open-ephys/ephys-test-module-molc-64-chan/README.md

# Test Module for FOLC-based Headstages and Adapters

This test module works with the Open Ephys
[automated ephys tester](https://github.com/open-ephys/ephys-test-board). 
It can be used to verify the functionality of headstage-adapters and headstages that use the nanoZ/FOLC-110-01-S-Q_1 pinout.
