open-ephys/ephys-test-module-molc-64-chan/resources/nano-z_molc_pinout.ods

E0 | REF | REF | E24
E1 | x | x | E25
E2 | x | x | E26
E3 | x | x | E27
E5 | E4 | E29 | E28
E7 | E6 | E31 | E30
E9 | E8 | E17 | E16
E11 | E10 | E19 | E18
E13 | E12 | E21 | E20
E15 | E14 | E23 | E22
E32 | REF | REF | E56
E33 | x | x | E57
E34 | x | x | E58
E35 | x | x | E59
E37 | E36 | E61 | E60
E39 | E38 | E63 | E62
E41 | E40 | E49 | E48
E43 | E42 | E51 | E50
E45 | E44 | E53 | E52
E47 | E46 | E55 | E54
