open-ephys/ephys-test-module-molc-64-chan/pcb/ephys-test-module-molc-64-chan.pdf

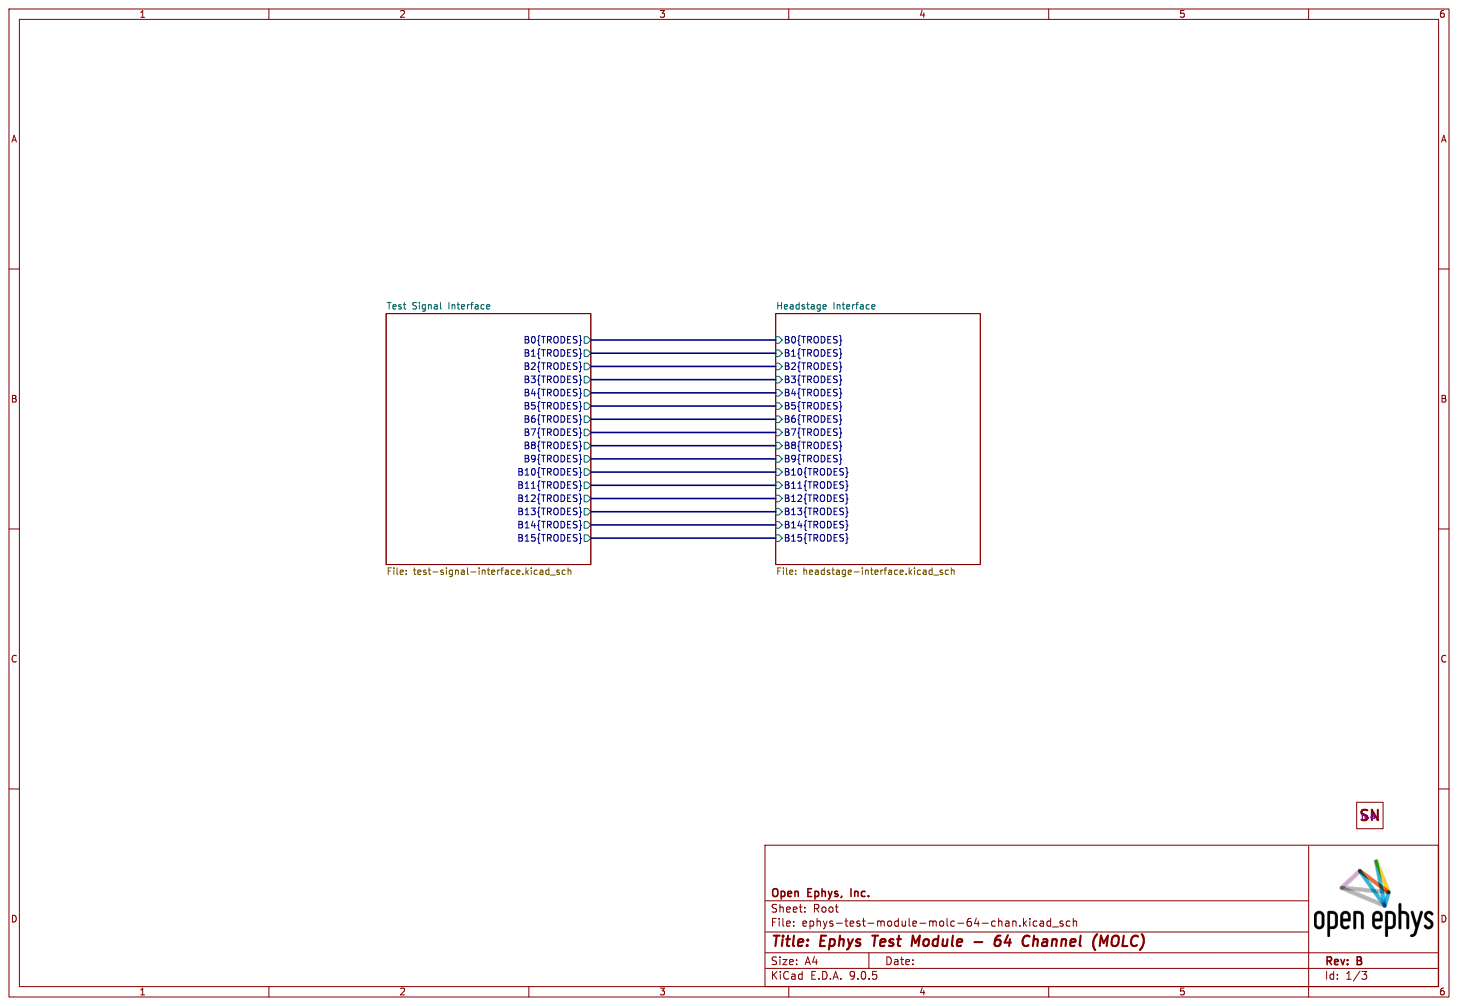
[picture p1: page 1]

B15{TRODES} Test Signal Interface File: test-signal-interface.kicad_sch

Headstage Interface File: headstage-interface.kicad_sch

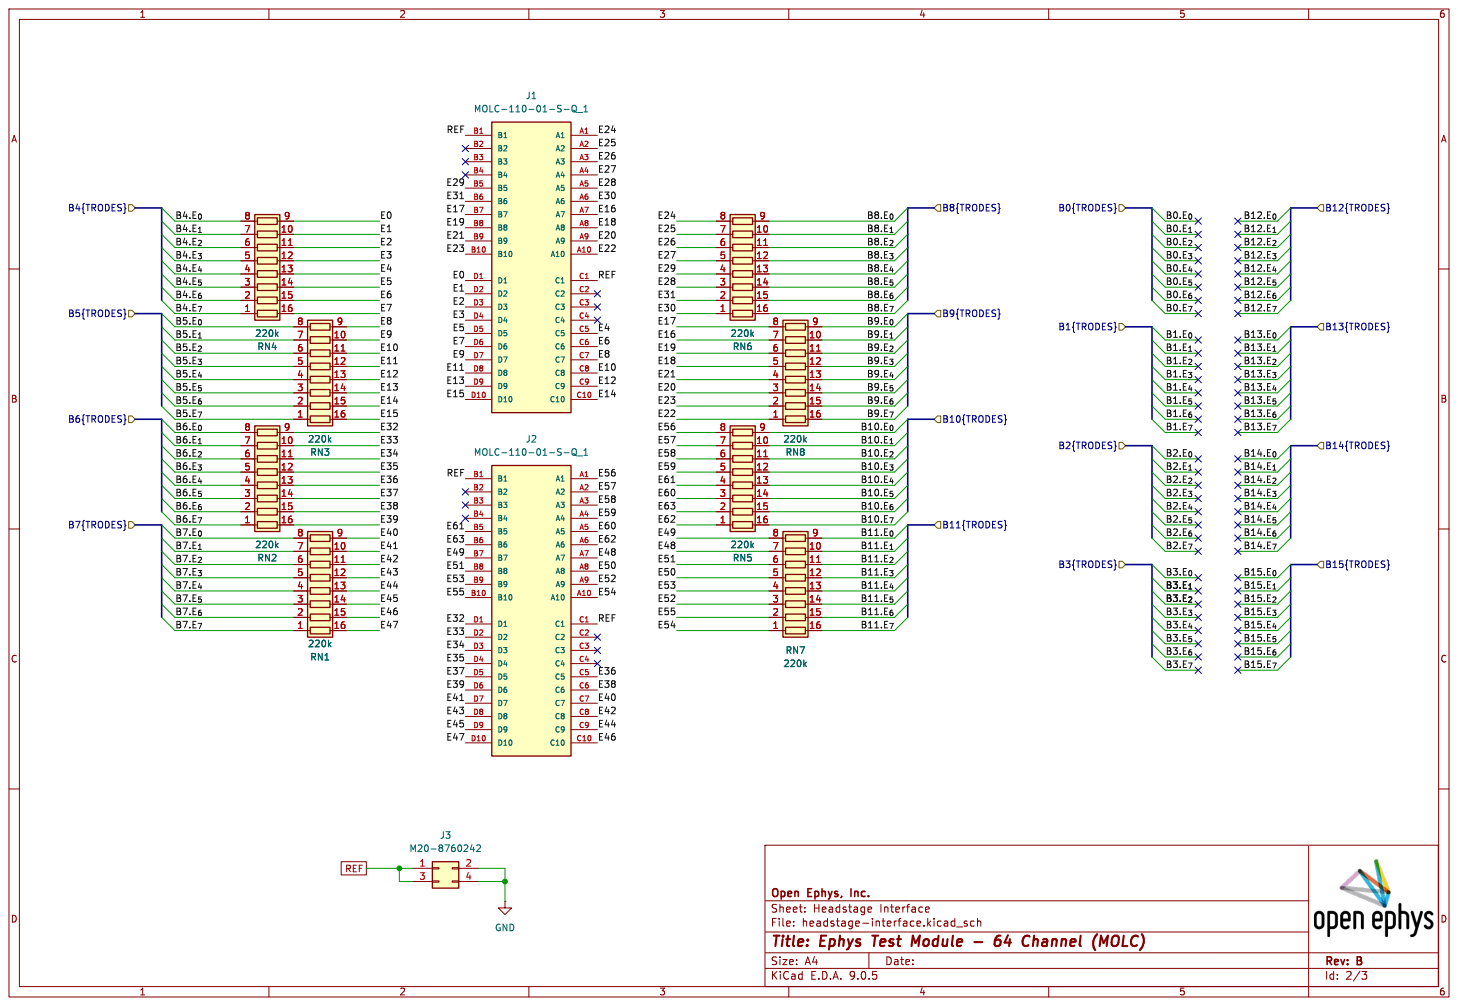
[picture p2: page 2]

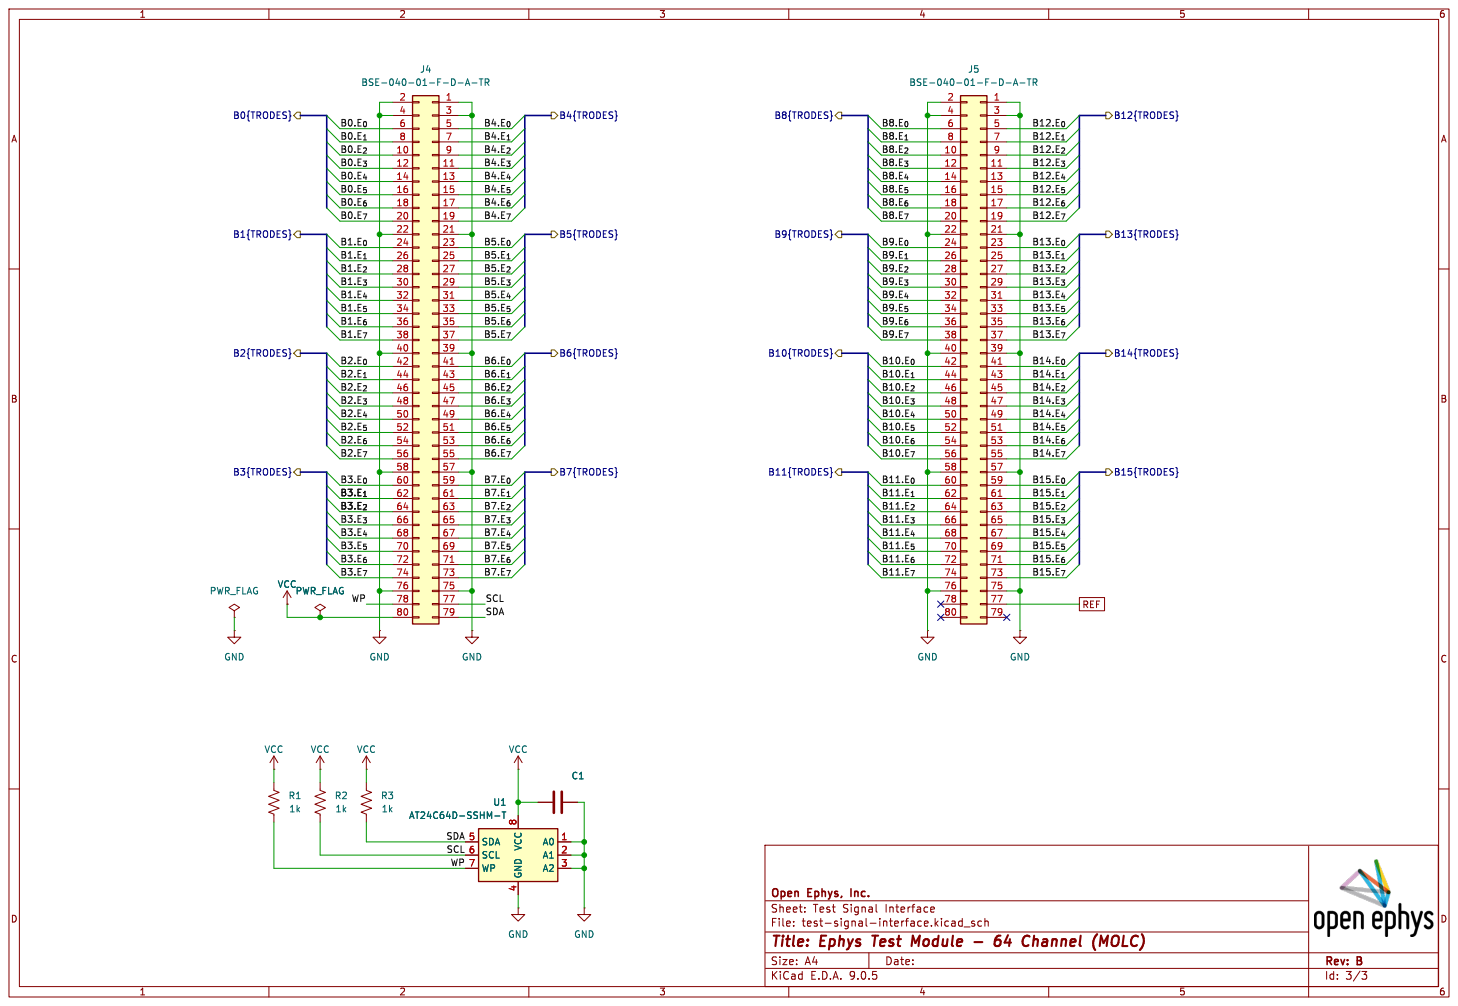
[picture p3: page 3]
