open-ephys/ephys-test-module-molc-64-chan/pcb/ephys-test-module-molc-64-chan.kicad_pcb

## KiCad design pcb/ephys-test-module-molc-64-chan.kicad_pcb (2025-11-03)

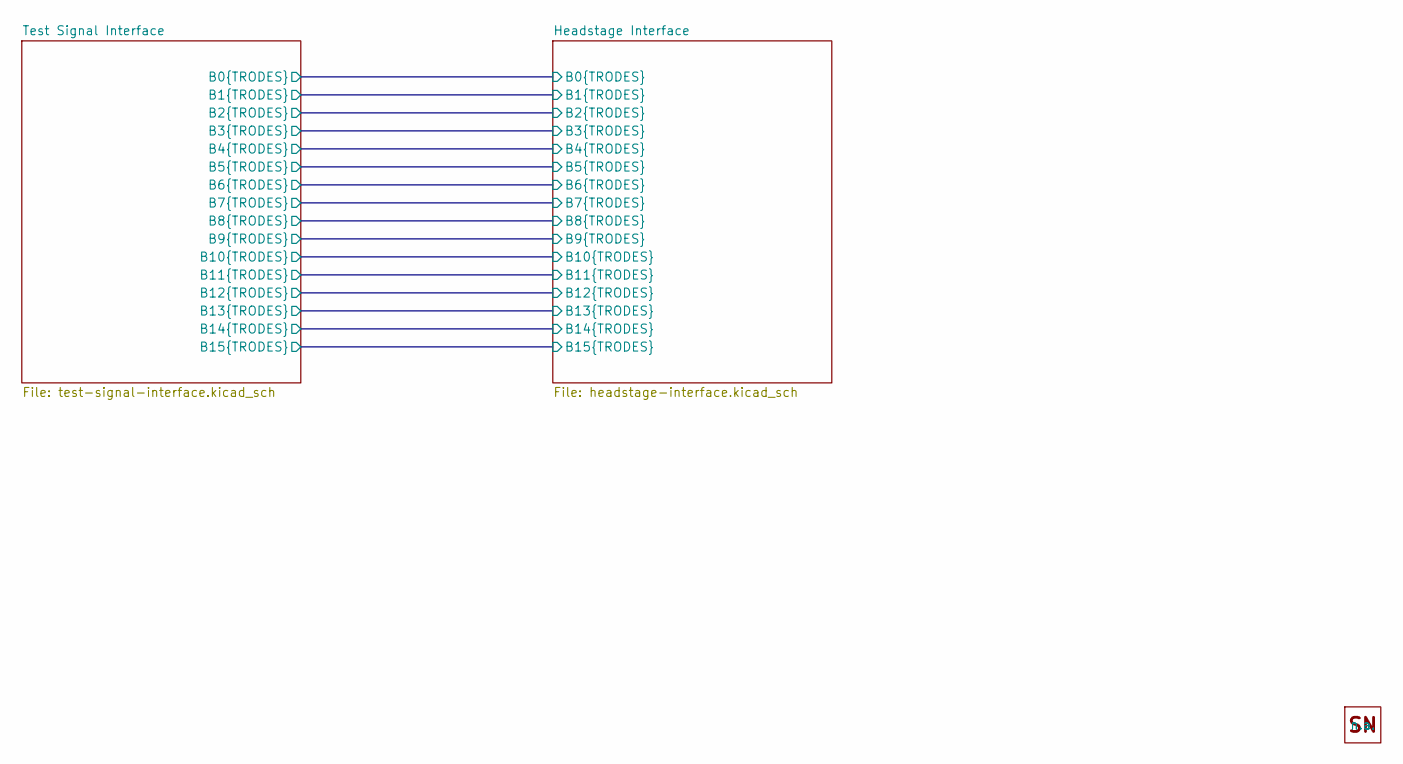
[picture p4: schematic ephys-test-module-molc-64-chan.kicad_sch, Ephys Test Module - 64 Channel (MOLC)]

Parts:
H1: OEPS_SN-STICKER-8x20mm; MPN n.a.

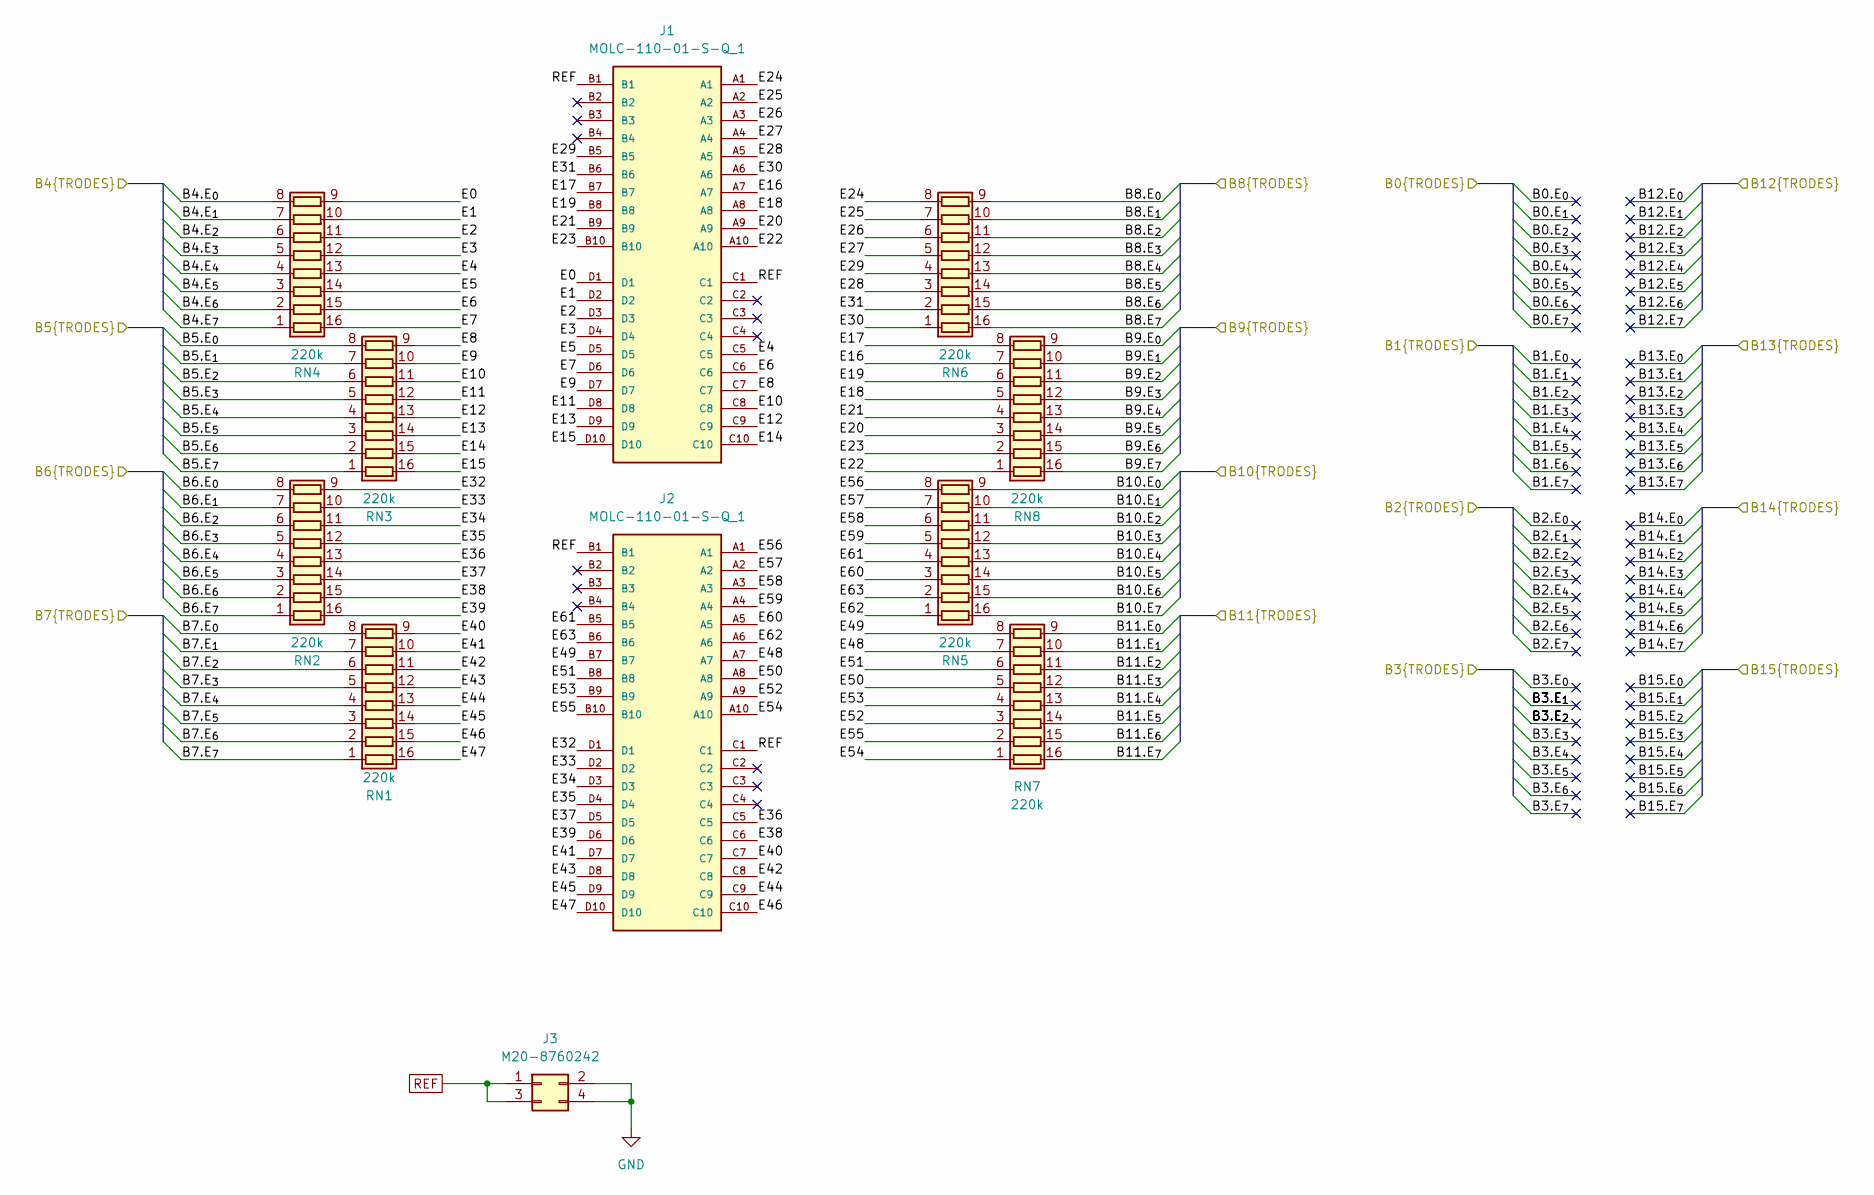
[picture p5: schematic headstage-interface.kicad_sch, Ephys Test Module - 64 Channel (MOLC)]

Parts:
J1, J2: MOLC-110-01-S-Q_1; SAMTEC_MOLC-110-01-S-Q; MPN MOLC-110-01-S-Q_1
J3: M20-8760242; PinHeader_2x02_P2.54mm_Vertical_SMD; MPN M20-8760242
RN1, RN2, RN3, RN4, RN5, RN6, RN7, RN8: 220k; R_Array_Convex_8x0602; Tolerance 5%; MPN YC248-JR-07220KL

Connections:
/Headstage Interface/B4.E_{0}: RN4.8 (R8.1); also elsewhere on the board
/Headstage Interface/B4.E_{1}: RN4.7 (R7.1); also elsewhere on the board
/Headstage Interface/B4.E_{2}: RN4.6 (R6.1); also elsewhere on the board
/Headstage Interface/B4.E_{3}: RN4.5 (R5.1); also elsewhere on the board
/Headstage Interface/B4.E_{4}: RN4.4 (R4.1); also elsewhere on the board
/Headstage Interface/B4.E_{5}: RN4.3 (R3.1); also elsewhere on the board
/Headstage Interface/B4.E_{6}: RN4.2 (R2.1); also elsewhere on the board
/Headstage Interface/B4.E_{7}: RN4.1 (R1.1); also elsewhere on the board
/Headstage Interface/B5.E_{0}: RN3.8 (R8.1); also elsewhere on the board
/Headstage Interface/B5.E_{1}: RN3.7 (R7.1); also elsewhere on the board
/Headstage Interface/B5.E_{2}: RN3.6 (R6.1); also elsewhere on the board
/Headstage Interface/B5.E_{3}: RN3.5 (R5.1); also elsewhere on the board
/Headstage Interface/B5.E_{4}: RN3.4 (R4.1); also elsewhere on the board
/Headstage Interface/B5.E_{5}: RN3.3 (R3.1); also elsewhere on the board
/Headstage Interface/B5.E_{6}: RN3.2 (R2.1); also elsewhere on the board
/Headstage Interface/B5.E_{7}: RN3.1 (R1.1); also elsewhere on the board
/Headstage Interface/B6.E_{0}: RN2.8 (R8.1); also elsewhere on the board
/Headstage Interface/B6.E_{1}: RN2.7 (R7.1); also elsewhere on the board
/Headstage Interface/B6.E_{2}: RN2.6 (R6.1); also elsewhere on the board
/Headstage Interface/B6.E_{3}: RN2.5 (R5.1); also elsewhere on the board
/Headstage Interface/B6.E_{4}: RN2.4 (R4.1); also elsewhere on the board
/Headstage Interface/B6.E_{5}: RN2.3 (R3.1); also elsewhere on the board
/Headstage Interface/B6.E_{6}: RN2.2 (R2.1); also elsewhere on the board
/Headstage Interface/B6.E_{7}: RN2.1 (R1.1); also elsewhere on the board
/Headstage Interface/B7.E_{0}: RN1.8 (R8.1); also elsewhere on the board
/Headstage Interface/B7.E_{1}: RN1.7 (R7.1); also elsewhere on the board
/Headstage Interface/B7.E_{2}: RN1.6 (R6.1); also elsewhere on the board
/Headstage Interface/B7.E_{3}: RN1.5 (R5.1); also elsewhere on the board
/Headstage Interface/B7.E_{4}: RN1.4 (R4.1); also elsewhere on the board
/Headstage Interface/B7.E_{5}: RN1.3 (R3.1); also elsewhere on the board
/Headstage Interface/B7.E_{6}: RN1.2 (R2.1); also elsewhere on the board
/Headstage Interface/B7.E_{7}: RN1.1 (R1.1); also elsewhere on the board
/Headstage Interface/B8.E_{0}: RN6.9 (R8.2); also elsewhere on the board
/Headstage Interface/B8.E_{1}: RN6.10 (R7.2); also elsewhere on the board
/Headstage Interface/B8.E_{2}: RN6.11 (R6.2); also elsewhere on the board
/Headstage Interface/B8.E_{3}: RN6.12 (R5.2); also elsewhere on the board
/Headstage Interface/B8.E_{4}: RN6.13 (R4.2); also elsewhere on the board
/Headstage Interface/B8.E_{5}: RN6.14 (R3.2); also elsewhere on the board
/Headstage Interface/B8.E_{6}: RN6.15 (R2.2); also elsewhere on the board
/Headstage Interface/B8.E_{7}: RN6.16 (R1.2); also elsewhere on the board
/Headstage Interface/B9.E_{0}: RN8.9 (R8.2); also elsewhere on the board
/Headstage Interface/B9.E_{1}: RN8.10 (R7.2); also elsewhere on the board
/Headstage Interface/B9.E_{2}: RN8.11 (R6.2); also elsewhere on the board
/Headstage Interface/B9.E_{3}: RN8.12 (R5.2); also elsewhere on the board
/Headstage Interface/B9.E_{4}: RN8.13 (R4.2); also elsewhere on the board
/Headstage Interface/B9.E_{5}: RN8.14 (R3.2); also elsewhere on the board
/Headstage Interface/B9.E_{6}: RN8.15 (R2.2); also elsewhere on the board
/Headstage Interface/B9.E_{7}: RN8.16 (R1.2); also elsewhere on the board
/Headstage Interface/B10.E_{0}: RN5.9 (R8.2); also elsewhere on the board
/Headstage Interface/B10.E_{1}: RN5.10 (R7.2); also elsewhere on the board
/Headstage Interface/B10.E_{2}: RN5.11 (R6.2); also elsewhere on the board
/Headstage Interface/B10.E_{3}: RN5.12 (R5.2); also elsewhere on the board
/Headstage Interface/B10.E_{4}: RN5.13 (R4.2); also elsewhere on the board
/Headstage Interface/B10.E_{5}: RN5.14 (R3.2); also elsewhere on the board
/Headstage Interface/B10.E_{6}: RN5.15 (R2.2); also elsewhere on the board
/Headstage Interface/B10.E_{7}: RN5.16 (R1.2); also elsewhere on the board
/Headstage Interface/B11.E_{0}: RN7.9 (R8.2); also elsewhere on the board
/Headstage Interface/B11.E_{1}: RN7.10 (R7.2); also elsewhere on the board
/Headstage Interface/B11.E_{2}: RN7.11 (R6.2); also elsewhere on the board
/Headstage Interface/B11.E_{3}: RN7.12 (R5.2); also elsewhere on the board
/Headstage Interface/B11.E_{4}: RN7.13 (R4.2); also elsewhere on the board
/Headstage Interface/B11.E_{5}: RN7.14 (R3.2); also elsewhere on the board
/Headstage Interface/B11.E_{6}: RN7.15 (R2.2); also elsewhere on the board
/Headstage Interface/B11.E_{7}: RN7.16 (R1.2); also elsewhere on the board
/Headstage Interface/E0: J1.D1, RN4.9 (R8.2)
/Headstage Interface/E1: J1.D2, RN4.10 (R7.2)
/Headstage Interface/E2: J1.D3, RN4.11 (R6.2)
/Headstage Interface/E3: J1.D4, RN4.12 (R5.2)
/Headstage Interface/E4: J1.C5, RN4.13 (R4.2)
/Headstage Interface/E5: J1.D5, RN4.14 (R3.2)
/Headstage Interface/E6: J1.C6, RN4.15 (R2.2)
/Headstage Interface/E7: J1.D6, RN4.16 (R1.2)
/Headstage Interface/E8: J1.C7, RN3.9 (R8.2)
/Headstage Interface/E9: J1.D7, RN3.10 (R7.2)
/Headstage Interface/E10: J1.C8, RN3.11 (R6.2)
/Headstage Interface/E11: J1.D8, RN3.12 (R5.2)
/Headstage Interface/E12: J1.C9, RN3.13 (R4.2)
/Headstage Interface/E13: J1.D9, RN3.14 (R3.2)
/Headstage Interface/E14: J1.C10, RN3.15 (R2.2)
/Headstage Interface/E15: J1.D10, RN3.16 (R1.2)
/Headstage Interface/E16: J1.A7, RN8.7 (R7.1)
/Headstage Interface/E17: J1.B7, RN8.8 (R8.1)
/Headstage Interface/E18: J1.A8, RN8.5 (R5.1)
/Headstage Interface/E19: J1.B8, RN8.6 (R6.1)
/Headstage Interface/E20: J1.A9, RN8.3 (R3.1)
/Headstage Interface/E21: J1.B9, RN8.4 (R4.1)
/Headstage Interface/E22: J1.A10, RN8.1 (R1.1)
/Headstage Interface/E23: J1.B10, RN8.2 (R2.1)
/Headstage Interface/E24: J1.A1, RN6.8 (R8.1)
/Headstage Interface/E25: J1.A2, RN6.7 (R7.1)
/Headstage Interface/E26: J1.A3, RN6.6 (R6.1)
/Headstage Interface/E27: J1.A4, RN6.5 (R5.1)
/Headstage Interface/E28: J1.A5, RN6.3 (R3.1)
/Headstage Interface/E29: J1.B5, RN6.4 (R4.1)
/Headstage Interface/E30: J1.A6, RN6.1 (R1.1)
/Headstage Interface/E31: J1.B6, RN6.2 (R2.1)
/Headstage Interface/E32: J2.D1, RN2.9 (R8.2)
/Headstage Interface/E33: J2.D2, RN2.10 (R7.2)
/Headstage Interface/E34: J2.D3, RN2.11 (R6.2)
/Headstage Interface/E35: J2.D4, RN2.12 (R5.2)
/Headstage Interface/E36: J2.C5, RN2.13 (R4.2)
/Headstage Interface/E37: J2.D5, RN2.14 (R3.2)
/Headstage Interface/E38: J2.C6, RN2.15 (R2.2)
/Headstage Interface/E39: J2.D6, RN2.16 (R1.2)
/Headstage Interface/E40: J2.C7, RN1.9 (R8.2)
/Headstage Interface/E41: J2.D7, RN1.10 (R7.2)
/Headstage Interface/E42: J2.C8, RN1.11 (R6.2)
/Headstage Interface/E43: J2.D8, RN1.12 (R5.2)
/Headstage Interface/E44: J2.C9, RN1.13 (R4.2)
/Headstage Interface/E45: J2.D9, RN1.14 (R3.2)
/Headstage Interface/E46: J2.C10, RN1.15 (R2.2)
/Headstage Interface/E47: J2.D10, RN1.16 (R1.2)
/Headstage Interface/E48: J2.A7, RN7.7 (R7.1)
/Headstage Interface/E49: J2.B7, RN7.8 (R8.1)
/Headstage Interface/E50: J2.A8, RN7.5 (R5.1)
/Headstage Interface/E51: J2.B8, RN7.6 (R6.1)
/Headstage Interface/E52: J2.A9, RN7.3 (R3.1)
/Headstage Interface/E53: J2.B9, RN7.4 (R4.1)
/Headstage Interface/E54: J2.A10, RN7.1 (R1.1)
/Headstage Interface/E55: J2.B10, RN7.2 (R2.1)
/Headstage Interface/E56: J2.A1, RN5.8 (R8.1)
/Headstage Interface/E57: J2.A2, RN5.7 (R7.1)
/Headstage Interface/E58: J2.A3, RN5.6 (R6.1)
/Headstage Interface/E59: J2.A4, RN5.5 (R5.1)
/Headstage Interface/E60: J2.A5, RN5.3 (R3.1)
/Headstage Interface/E61: J2.B5, RN5.4 (R4.1)
/Headstage Interface/E62: J2.A6, RN5.1 (R1.1)
/Headstage Interface/E63: J2.B6, RN5.2 (R2.1)
GND: J3.2, J3.4; also elsewhere on the board
REF: J1.B1, J1.C1, J2.B1, J2.C1, J3.1, J3.3; also elsewhere on the board

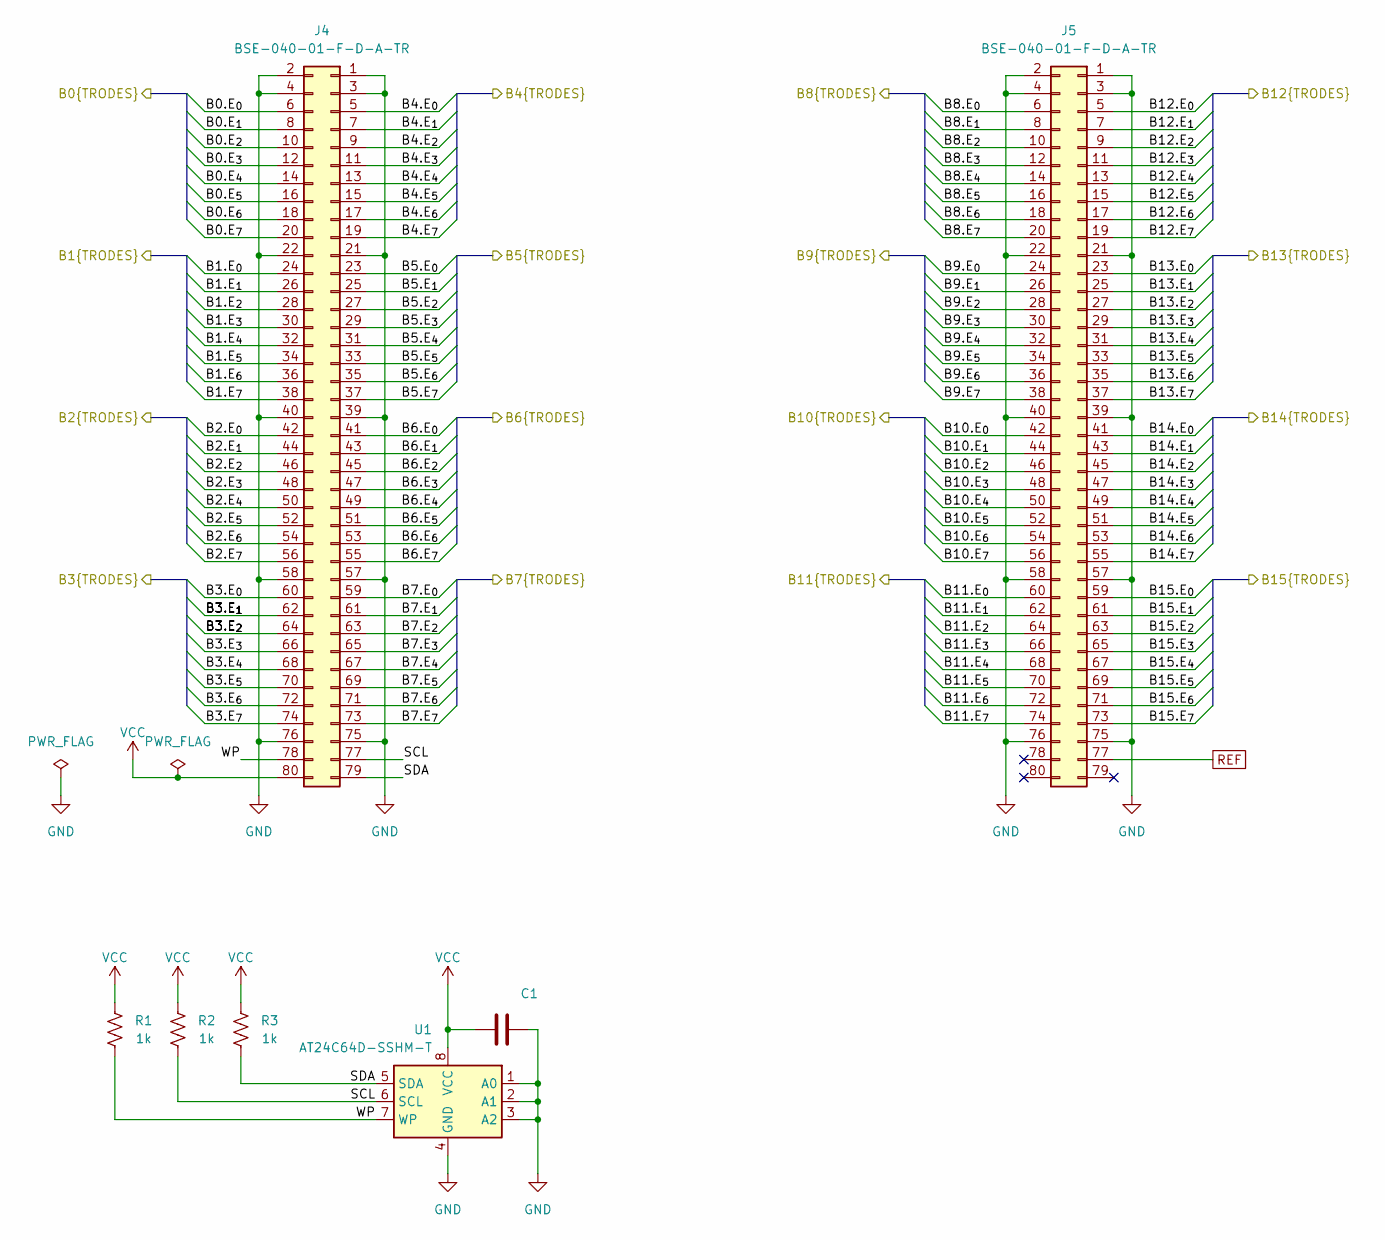
[picture p6: schematic test-signal-interface.kicad_sch, Ephys Test Module - 64 Channel (MOLC)]

Parts:
C1: 100nF; C_0402_1005Metric; Tolerance X5R; MPN C1005X5R1V104K050BB
J4, J5: BSE-040-01-F-D-A-TR; SAMTEC_BSE-040-01-X-D-A; MPN BSE-040-01-F-D-A-TR
R1, R2, R3: 1k; R_0402_1005Metric; Tolerance 1%; MPN CRCW04021K00FKED
U1: AT24C64D-SSHM-T; SOIC-8_3.9x4.9mm_P1.27mm; MPN AT24C64D-SSHM-T

Connections:
/Headstage Interface/B0.E_{0}: J4.6
/Headstage Interface/B0.E_{1}: J4.8
/Headstage Interface/B0.E_{2}: J4.10
/Headstage Interface/B0.E_{3}: J4.12
/Headstage Interface/B0.E_{4}: J4.14
/Headstage Interface/B0.E_{5}: J4.16
/Headstage Interface/B0.E_{6}: J4.18
/Headstage Interface/B0.E_{7}: J4.20
/Headstage Interface/B1.E_{0}: J4.24
/Headstage Interface/B1.E_{1}: J4.26
/Headstage Interface/B1.E_{2}: J4.28
/Headstage Interface/B1.E_{3}: J4.30
/Headstage Interface/B1.E_{4}: J4.32
/Headstage Interface/B1.E_{5}: J4.34
/Headstage Interface/B1.E_{6}: J4.36
/Headstage Interface/B1.E_{7}: J4.38
/Headstage Interface/B2.E_{0}: J4.42
/Headstage Interface/B2.E_{1}: J4.44
/Headstage Interface/B2.E_{2}: J4.46
/Headstage Interface/B2.E_{3}: J4.48
/Headstage Interface/B2.E_{4}: J4.50
/Headstage Interface/B2.E_{5}: J4.52
/Headstage Interface/B2.E_{6}: J4.54
/Headstage Interface/B2.E_{7}: J4.56
/Headstage Interface/B3.E_{0}: J4.60
/Headstage Interface/B3.E_{1}: J4.62
/Headstage Interface/B3.E_{2}: J4.64
/Headstage Interface/B3.E_{3}: J4.66
/Headstage Interface/B3.E_{4}: J4.68
/Headstage Interface/B3.E_{5}: J4.70
/Headstage Interface/B3.E_{6}: J4.72
/Headstage Interface/B3.E_{7}: J4.74
/Headstage Interface/B4.E_{0}: J4.5; also elsewhere on the board
/Headstage Interface/B4.E_{1}: J4.7; also elsewhere on the board
/Headstage Interface/B4.E_{2}: J4.9; also elsewhere on the board
/Headstage Interface/B4.E_{3}: J4.11; also elsewhere on the board
/Headstage Interface/B4.E_{4}: J4.13; also elsewhere on the board
/Headstage Interface/B4.E_{5}: J4.15; also elsewhere on the board
/Headstage Interface/B4.E_{6}: J4.17; also elsewhere on the board
/Headstage Interface/B4.E_{7}: J4.19; also elsewhere on the board
/Headstage Interface/B5.E_{0}: J4.23; also elsewhere on the board
/Headstage Interface/B5.E_{1}: J4.25; also elsewhere on the board
/Headstage Interface/B5.E_{2}: J4.27; also elsewhere on the board
/Headstage Interface/B5.E_{3}: J4.29; also elsewhere on the board
/Headstage Interface/B5.E_{4}: J4.31; also elsewhere on the board
/Headstage Interface/B5.E_{5}: J4.33; also elsewhere on the board
/Headstage Interface/B5.E_{6}: J4.35; also elsewhere on the board
/Headstage Interface/B5.E_{7}: J4.37; also elsewhere on the board
/Headstage Interface/B6.E_{0}: J4.41; also elsewhere on the board
/Headstage Interface/B6.E_{1}: J4.43; also elsewhere on the board
/Headstage Interface/B6.E_{2}: J4.45; also elsewhere on the board
/Headstage Interface/B6.E_{3}: J4.47; also elsewhere on the board
/Headstage Interface/B6.E_{4}: J4.49; also elsewhere on the board
/Headstage Interface/B6.E_{5}: J4.51; also elsewhere on the board
/Headstage Interface/B6.E_{6}: J4.53; also elsewhere on the board
/Headstage Interface/B6.E_{7}: J4.55; also elsewhere on the board
/Headstage Interface/B7.E_{0}: J4.59; also elsewhere on the board
/Headstage Interface/B7.E_{1}: J4.61; also elsewhere on the board
/Headstage Interface/B7.E_{2}: J4.63; also elsewhere on the board
/Headstage Interface/B7.E_{3}: J4.65; also elsewhere on the board
/Headstage Interface/B7.E_{4}: J4.67; also elsewhere on the board
/Headstage Interface/B7.E_{5}: J4.69; also elsewhere on the board
/Headstage Interface/B7.E_{6}: J4.71; also elsewhere on the board
/Headstage Interface/B7.E_{7}: J4.73; also elsewhere on the board
/Headstage Interface/B8.E_{0}: J5.6; also elsewhere on the board
/Headstage Interface/B8.E_{1}: J5.8; also elsewhere on the board
/Headstage Interface/B8.E_{2}: J5.10; also elsewhere on the board
/Headstage Interface/B8.E_{3}: J5.12; also elsewhere on the board
/Headstage Interface/B8.E_{4}: J5.14; also elsewhere on the board
/Headstage Interface/B8.E_{5}: J5.16; also elsewhere on the board
/Headstage Interface/B8.E_{6}: J5.18; also elsewhere on the board
/Headstage Interface/B8.E_{7}: J5.20; also elsewhere on the board
/Headstage Interface/B9.E_{0}: J5.24; also elsewhere on the board
/Headstage Interface/B9.E_{1}: J5.26; also elsewhere on the board
/Headstage Interface/B9.E_{2}: J5.28; also elsewhere on the board
/Headstage Interface/B9.E_{3}: J5.30; also elsewhere on the board
/Headstage Interface/B9.E_{4}: J5.32; also elsewhere on the board
/Headstage Interface/B9.E_{5}: J5.34; also elsewhere on the board
/Headstage Interface/B9.E_{6}: J5.36; also elsewhere on the board
/Headstage Interface/B9.E_{7}: J5.38; also elsewhere on the board
/Headstage Interface/B10.E_{0}: J5.42; also elsewhere on the board
/Headstage Interface/B10.E_{1}: J5.44; also elsewhere on the board
/Headstage Interface/B10.E_{2}: J5.46; also elsewhere on the board
/Headstage Interface/B10.E_{3}: J5.48; also elsewhere on the board
/Headstage Interface/B10.E_{4}: J5.50; also elsewhere on the board
/Headstage Interface/B10.E_{5}: J5.52; also elsewhere on the board
/Headstage Interface/B10.E_{6}: J5.54; also elsewhere on the board
/Headstage Interface/B10.E_{7}: J5.56; also elsewhere on the board
/Headstage Interface/B11.E_{0}: J5.60; also elsewhere on the board
/Headstage Interface/B11.E_{1}: J5.62; also elsewhere on the board
/Headstage Interface/B11.E_{2}: J5.64; also elsewhere on the board
/Headstage Interface/B11.E_{3}: J5.66; also elsewhere on the board
/Headstage Interface/B11.E_{4}: J5.68; also elsewhere on the board
/Headstage Interface/B11.E_{5}: J5.70; also elsewhere on the board
/Headstage Interface/B11.E_{6}: J5.72; also elsewhere on the board
/Headstage Interface/B11.E_{7}: J5.74; also elsewhere on the board
/Headstage Interface/B12.E_{0}: J5.5
/Headstage Interface/B12.E_{1}: J5.7
/Headstage Interface/B12.E_{2}: J5.9
/Headstage Interface/B12.E_{3}: J5.11
/Headstage Interface/B12.E_{4}: J5.13
/Headstage Interface/B12.E_{5}: J5.15
/Headstage Interface/B12.E_{6}: J5.17
/Headstage Interface/B12.E_{7}: J5.19
/Headstage Interface/B13.E_{0}: J5.23
/Headstage Interface/B13.E_{1}: J5.25
/Headstage Interface/B13.E_{2}: J5.27
/Headstage Interface/B13.E_{3}: J5.29
/Headstage Interface/B13.E_{4}: J5.31
/Headstage Interface/B13.E_{5}: J5.33
/Headstage Interface/B13.E_{6}: J5.35
/Headstage Interface/B13.E_{7}: J5.37
/Headstage Interface/B14.E_{0}: J5.41
/Headstage Interface/B14.E_{1}: J5.43
/Headstage Interface/B14.E_{2}: J5.45
/Headstage Interface/B14.E_{3}: J5.47
/Headstage Interface/B14.E_{4}: J5.49
/Headstage Interface/B14.E_{5}: J5.51
/Headstage Interface/B14.E_{6}: J5.53
/Headstage Interface/B14.E_{7}: J5.55
/Headstage Interface/B15.E_{0}: J5.59
/Headstage Interface/B15.E_{1}: J5.61
/Headstage Interface/B15.E_{2}: J5.63
/Headstage Interface/B15.E_{3}: J5.65
/Headstage Interface/B15.E_{4}: J5.67
/Headstage Interface/B15.E_{5}: J5.69
/Headstage Interface/B15.E_{6}: J5.71
/Headstage Interface/B15.E_{7}: J5.73
/Test Signal Interface/SCL: J4.77, R2.2, U1.6 (SCL)
/Test Signal Interface/SDA: J4.79, R3.2, U1.5 (SDA)
/Test Signal Interface/WP: J4.78, R1.2, U1.7 (WP)
GND: C1.2, J4.1, J4.2, J4.3, J4.4, J4.21, J4.22, J4.39, J4.40, J4.57, J4.58, J4.75, J4.76, J5.1, J5.2, J5.3, J5.4, J5.21, J5.22, J5.39, J5.40, J5.57, J5.58, J5.75, J5.76, U1.1 (A0), U1.2 (A1), U1.3 (A2), U1.4 (GND); also elsewhere on the board
REF: J5.77; also elsewhere on the board
VCC: C1.1, J4.80, R1.1, R2.1, R3.1, U1.8 (VCC)

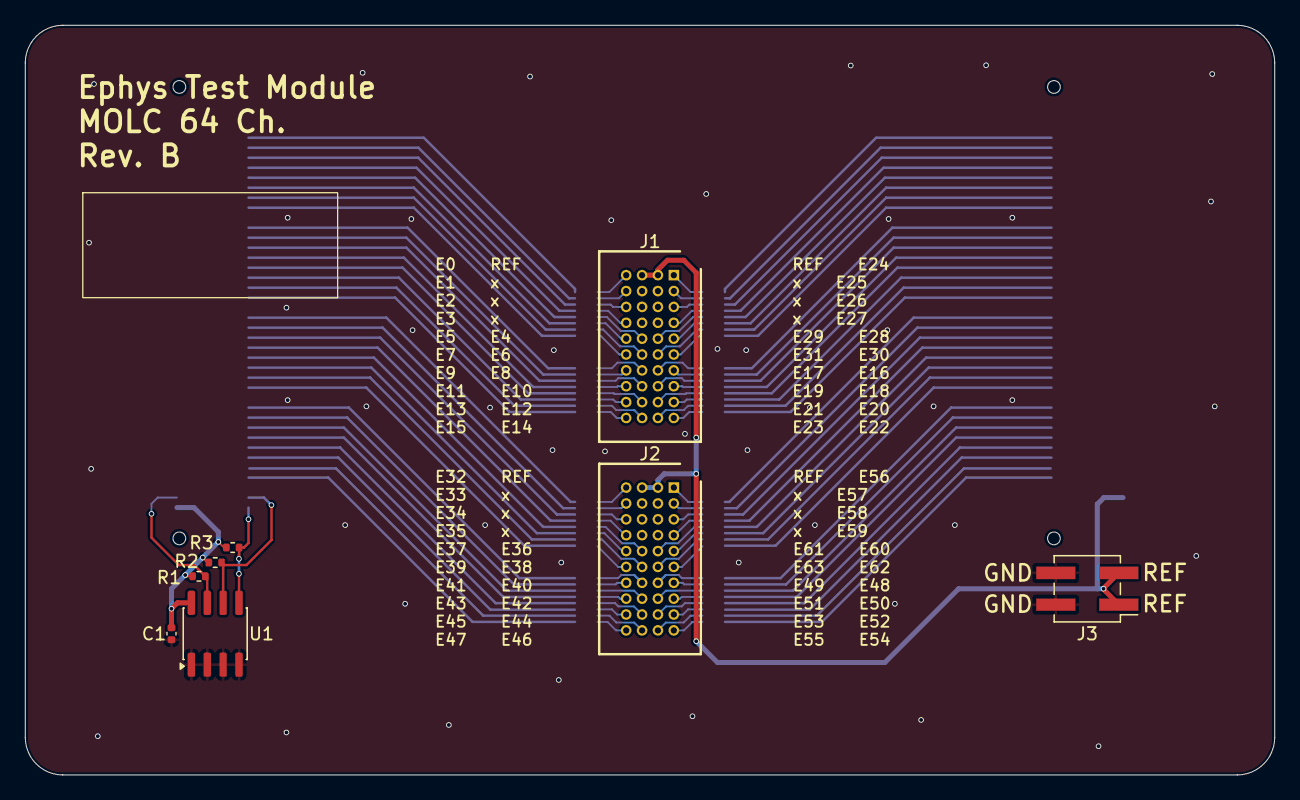
[picture p7: board ephys-test-module-molc-64-chan.kicad_pcb from above]

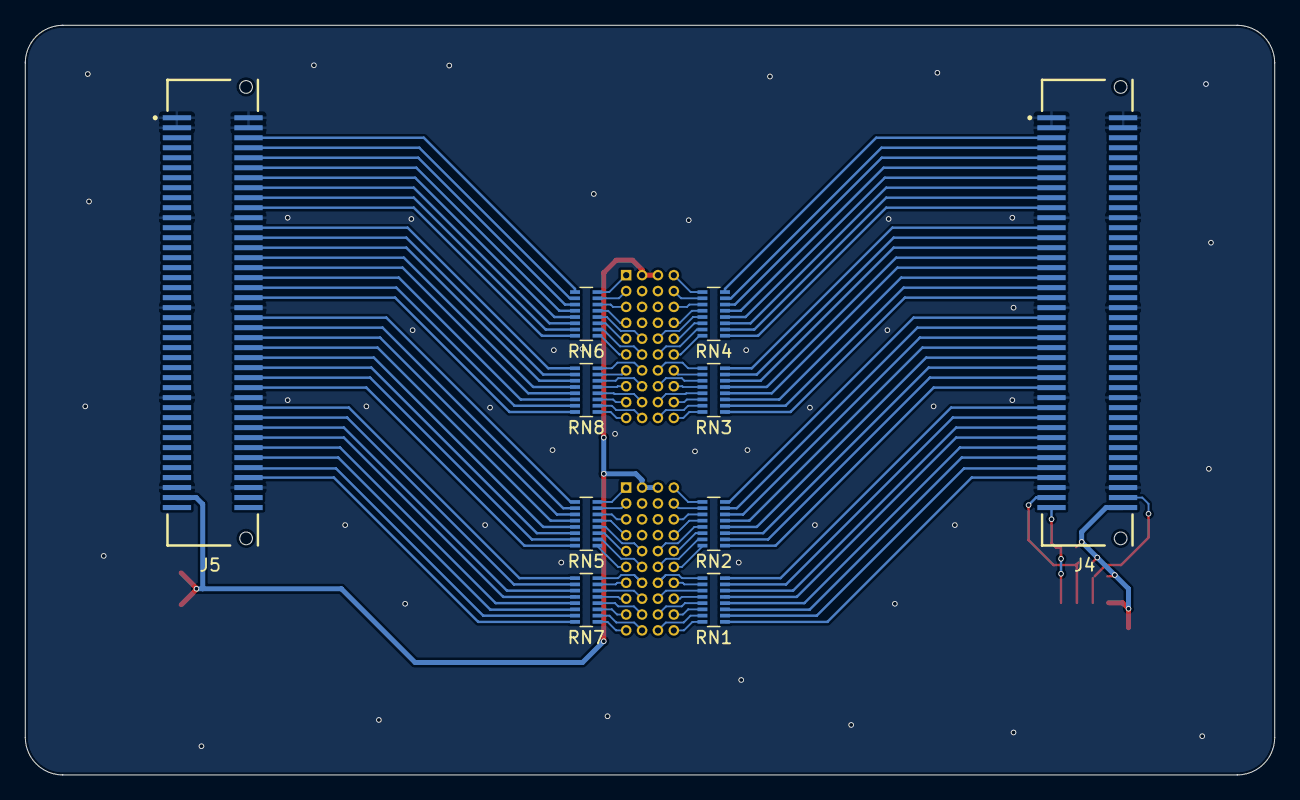
[picture p8: board ephys-test-module-molc-64-chan.kicad_pcb from below]

Board: 2 copper layers, 100.0 x 60.0 mm, 19 parts (10 on the bottom side), 134 nets.
