open-ephys/ephys-test-module-molc-64-chan/(commit log)

2025-10-01 Revision A
    [ephys-test-module-molc-64-chan-B_Cu.gbr, ephys-test-module-molc-64-chan-B_Fab.gbr, ephys-test-module-molc-64-chan-B_Mask.gbr, ephys-test-module-molc-64-chan-B_Paste.gbr, ephys-test-module-molc-64-chan-B_Silkscreen.gbr, ephys-test-module-molc-64-chan-Edge_Cuts.gbr, ephys-test-module-molc-64-chan-F_Cu.gbr, ephys-test-module-molc-64-chan-F_Fab.gbr]
2025-10-08 Add pdf of the schematic
2025-10-24 Revision B
    - Added 220k resistor arrays in series with amplifier connections to
    simulate electrodes
    [ephys-test-module-molc-64-chan-B_Cu.gbr, ephys-test-module-molc-64-chan-B_Fab.gbr, ephys-test-module-molc-64-chan-B_Mask.gbr, ephys-test-module-molc-64-chan-B_Paste.gbr, ephys-test-module-molc-64-chan-B_Silkscreen.gbr, ephys-test-module-molc-64-chan-Edge_Cuts.gbr, ephys-test-module-molc-64-chan-F_Cu.gbr, ephys-test-module-molc-64-chan-F_Fab.gbr]
2025-10-24 Add EEPROM programmer
    - This includes two channel maps. The first is the standard nano-z
    channel map. The second maps to the low-profile heastage (DF40) map
    through MOLC adapter board.
2025-11-03 Revision B
    - Widened traces to 0.2 mm
    [ephys-test-module-molc-64-chan-B_Cu.gbr, ephys-test-module-molc-64-chan-B_Fab.gbr, ephys-test-module-molc-64-chan-B_Mask.gbr, ephys-test-module-molc-64-chan-B_Paste.gbr, ephys-test-module-molc-64-chan-B_Silkscreen.gbr, ephys-test-module-molc-64-chan-Edge_Cuts.gbr, ephys-test-module-molc-64-chan-F_Cu.gbr, ephys-test-module-molc-64-chan-F_Fab.gbr]
